luigiSiu/glowgrid/README.md

# glowgrid

An 8×8 LED panel that sits on your desk and shows whether you can be
interrupted. It follows your Mac automatically — camera on means you are in a
meeting, microphone on means you are busy — and you can override it from the
menu bar at any time.

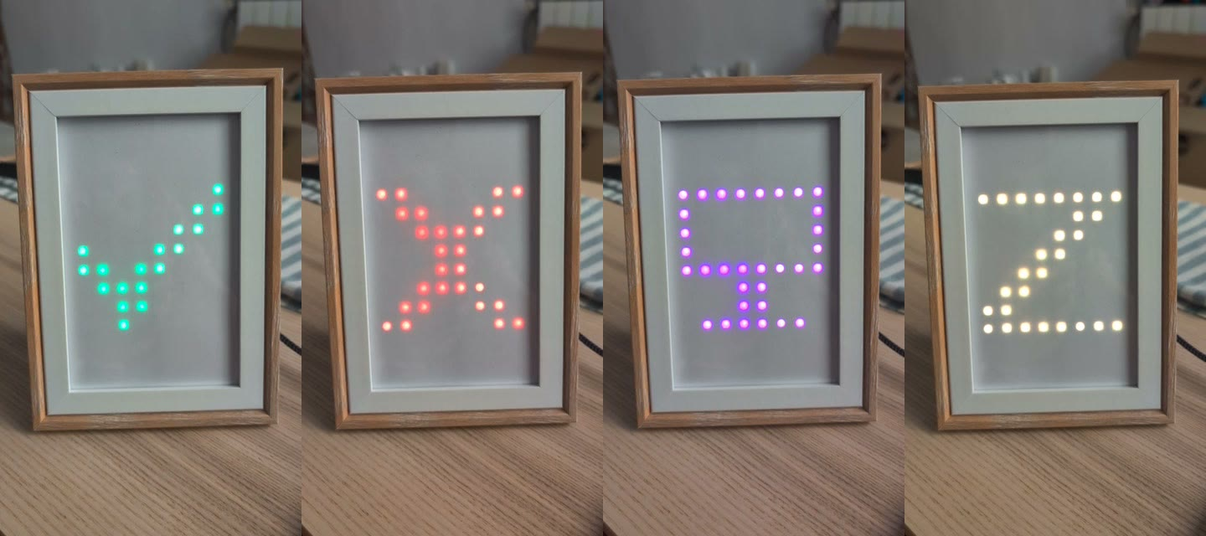
[picture p1: docs/media/states.jpg]
glowgrid in a photo frame, showing available, busy, in a meeting and away


Available, busy, in a meeting, away — behind the glass of a €6 photo frame.
▶ **[10-second clip of it cycling through the states](docs/media/frame-demo.mp4)**

About **€27 of parts** and an evening. No Xcode, no 3D printer, no breadboard,
and soldering is optional.

The Mac app is a
**[signed download](https://github.com/luigiSiu/glowgrid/releases)** — double
click and it runs. The panel you build yourself, and this README is the guide.

## What it shows

| Status | Icon | Colour |
|---|---|---|
| Available | tick | green |
| Busy | cross | red |
| In a meeting | monitor | purple |
| Away | Z | orange |
| Off | nothing | — |

Icons animate in from the centre, then breathe gently so the panel looks alive
rather than merely switched on. It can also scroll a short message.

## What you need

These are the exact parts this build used, at what they actually cost in Spain.
Nothing here is exotic or hard to substitute.

**Hardware**

- **ESP32 dev board** — [Diymore ESP32 NodeMCU, USB-C, CH340](https://www.amazon.es/dp/B0D9BTQRYT)
  — **€16 for a two-pack**, so about €8 for the one you need. Any ESP32 with
  Bluetooth works; there is nothing special about this one beyond being cheap
  and having USB-C. The pack of two is worth having anyway — a known-good spare
  is how you tell a wiring fault from a dead board.
- **WS2812B 8×8 LED matrix** — [BTF-LIGHTING WS2812B ECO, 64 pixels](https://www.amazon.es/dp/B088W62171)
  — **€13**. 80 × 80 mm, flexible, adhesive backed. Also sold as NeoPixel.
- **3 female-to-female dupont jumper leads** — a euro or two, and often already
  in the drawer.
- **A USB-C data cable.** Charge-only cables do not work and give no useful
  error whatsoever: the serial port simply never appears.
- **A photo frame**, if you want it to look finished — **under €6** from any
  cheap homeware shop. Not every frame will do; see
  [step 6](#6-put-it-in-a-photo-frame) for what to check before buying.

**Optional**

- **A USB power bank**, to run it away from the Mac —
  [Kuulaa 4500 mAh USB-C](https://www.amazon.es/dp/B0G1Y7CJ13) — **€17 for two**,
  about €8.50 each. These are tested on this build and run it without
  complaint, but read
  [Powering it from a USB battery](#powering-it-from-a-usb-battery) before buying
  any bank: capacity is not the specification that matters, and going wireless
  costs you Bluetooth range.

**Software** — a Mac running macOS 13 or later. The app itself needs nothing
installed: it is a signed, notarised download. Xcode Command Line Tools
(`xcode-select --install`) are only needed if you want to compile the app
yourself, and `arduino-cli` for the firmware — step 1 covers that.

**About €27 for one working unit**, or €36 with a battery. No resistors, no
level shifter, no breadboard, no 3D printer.

## Read this before wiring

`VIN` on the ESP32 is passed straight through from the USB 5 V rail, and USB
gives you about 500 mA. A single WS2812 LED can draw 60 mA at full white, so a
64-pixel panel at full white wants **around 3.8 A** — roughly eight times what
USB can supply.

That is fine here, because this project **never runs the panel bright**. The
firmware defaults to brightness 6 out of 255, caps it at 60, and tells FastLED
to keep total draw under 300 mA. At those levels a handful of lit pixels draws
tens of milliamps and USB power is comfortable.

Two rules follow:

- **Do not raise the brightness cap** unless you power the panel from a
  separate 5 V supply.
- If you do use an external supply, connect only `GND` and the data line to the
  ESP32, and make sure the grounds are common. **Never feed `VIN` from an
  external supply while USB is also plugged in.**

Low brightness is not just a power workaround, incidentally. These panels bloom
badly at desk distance and the icons read *better* dim than bright.

## Build it

### 1. Install the toolchain

```sh
brew install arduino-cli

arduino-cli config init
arduino-cli config add board_manager.additional_urls \
  https://espressif.github.io/arduino-esp32/package_esp32_index.json
arduino-cli core update-index
arduino-cli core install esp32:esp32
arduino-cli lib install FastLED
```

Note the board index URL. Many guides still list
`dl.espressif.com/dl/package_esp32_index.json`, which is the old one.

If you prefer the Arduino IDE, it shares `~/Library/Arduino15` with
`arduino-cli`, so configuring either configures both.

### 2. Prove the board works, before wiring anything

```sh
./flash.sh blink_test -m
```

`flash.sh` finds the serial port and pins the upload speed for you. The onboard
LED should blink once per second and the monitor should print `on` / `off`.

Do this first. If something is wrong with the board, the cable or the driver,
you want to find out now rather than while also suspecting your wiring.

**No port found?** Almost always the cable — try a known data cable before
anything else. Failing that, install the CH340 driver:

```sh
brew install --cask wch-ch34x-usb-serial-driver
```

then **restart your Mac** — not the ESP32 — and allow the kernel extension in
System Settings › Privacy & Security. This is a driver install, so it is the
Mac that needs the reboot.

**Upload hangs at `Connecting........`?** The board has two small buttons. Hold
**BOOT** as the upload starts, and release it once the dots give way to writing.
Some clones will not put themselves into the bootloader on their own.

If holding BOOT alone is not enough, do it by hand: **hold BOOT, tap EN, release
BOOT**, then start the upload. The board is now parked in the bootloader waiting
for it.

Which button is which, on the board pictured in step 3: **EN** is at the top,
next to the `VIN` end of the header. **BOOT** is at the bottom, beside the USB-C
socket. `EN` is *enable* — it simply resets the ESP32, and on its own it will not
get you into the bootloader. Worth knowing that at an angle the `EN` silkscreen
reads convincingly as `FN`.

### 3. Wire the panel

Unplug USB first.

| ESP32 pin | Panel pad |
|---|---|
| `VIN` | `5V` |
| `GND` | `GND` |
| `D13` | `DIN` |

Three wires. That is the entire circuit. `D13` on the silkscreen is `GPIO13`,
which is what the firmware drives.

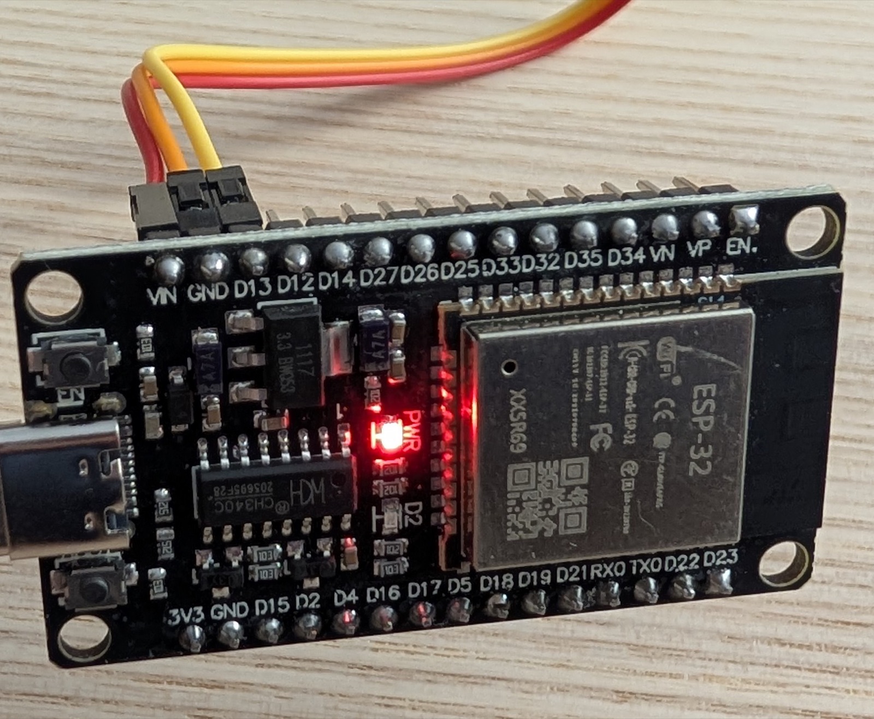
[picture p2: docs/media/esp32-wiring.jpg]
three jumper leads in VIN, GND and D13 on the ESP32


Ignore the colours of your jumper leads — the ones above are red, orange and
yellow and mean nothing at all. What matters is which pin each lands on, and
the silkscreen is legible in that photo: `VIN`, `GND` and `D13` are the first
three pins along that edge.

**The panel has three sets of wires and only one is the input.** Getting this
wrong is the most common way to end up with a dead-looking panel:

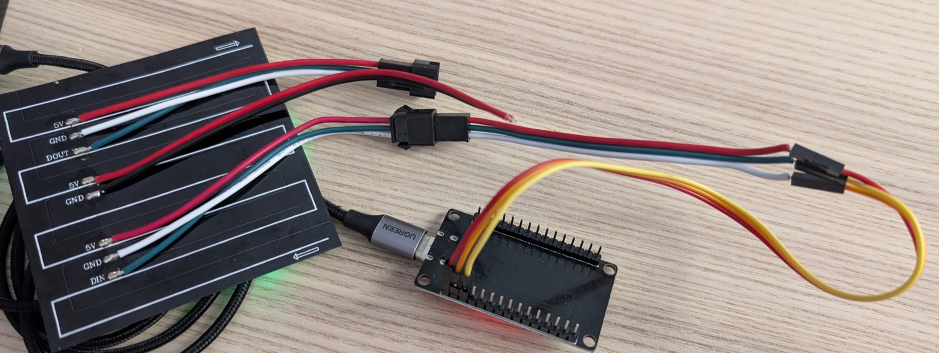
[picture p3: docs/media/panel-connectors.jpg]
the back of the panel, with all three wire sets and their labels


1. `5V`/`GND`/`DOUT`, male connector, arrow one way — the **output**, for
   chaining a second panel. Not used.
2. Two bare `5V`/`GND` wires with no connector — power injection, for an
   external supply. Not used here.
3. `5V`/`GND`/`DIN`, female connector, arrow the other way — the **input. This
   is the one.**

Each set is labelled on the PCB, as you can see above. The rule: data goes *in*
at `DIN`; `DOUT` is an exit. The arrows point opposite ways because the LED
chain snakes back and forth row by row.

Colours on the panel's own pigtail were verified by tracing on this build:
red = 5 V, white = GND, green = DIN. Pigtail colours are not guaranteed across
batches, so check yours against the printed labels rather than trusting colour.

When you hold two mated connectors face to face, the colour order *looks*
reversed. That is a mirror effect, not a fault.

**On soldering.** You do not have to solder anything. The pigtail ends push
straight into female dupont leads, and this project ran that way for weeks. It
is a friction fit though, so twist each bare end tightly, push it fully home,
and keep the three joints apart. Intermittent data shows up as flicker or wrong
colours; intermittent power shows up as the panel resetting — suspect these
joints first.

If you do own an iron, soldering the pigtail to a set of jumper leads (which is
what the photo above shows) takes ten minutes and removes that entire category
of fault. It is the one upgrade that makes the build feel less fragile.

### 4. Flash the firmware

```sh
./flash.sh
```

That builds and uploads `status_ble`, the sketch you actually want. The panel
should light up dim, and the board starts advertising over Bluetooth as
`glowgrid`.

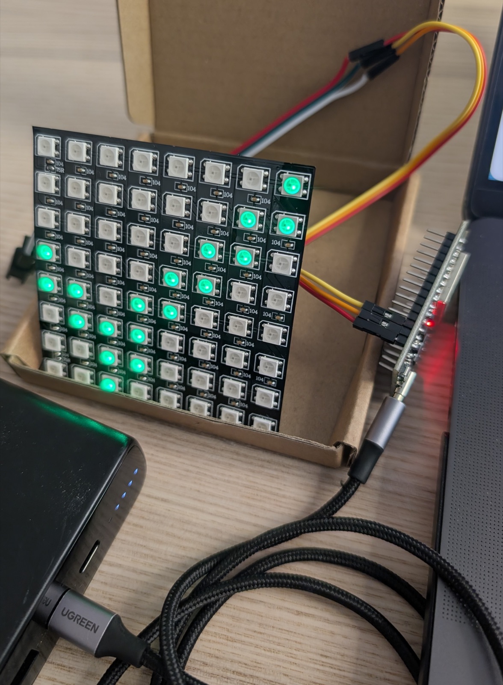
[picture p4: docs/media/bench-test.jpg]
the bare panel lit with a green tick, running from a USB power bank


First light. Two things in that photo are worth noticing, because each is the
point of a later step:

- It is running from a **USB power bank**, not the Mac. The panel does not care
  where its 5 V comes from — see
  [Powering it from a USB battery](#powering-it-from-a-usb-battery).
- Bare, the LEDs read as **64 separate dots** with visible halos. The shape is
  legible, but it looks like a circuit board, because it is one. Step 6 is what
  fixes that.

### 5. Install the Mac app

Download `Glowgrid-<version>.zip` from
[Releases](https://github.com/luigiSiu/glowgrid/releases), unzip it and drag the
app to `/Applications`. It is signed and notarised, so it opens with a double
click like anything else you download.

Or build it from source, which takes one command:

```sh
cd mac-app
./build.sh -i
```

This compiles the app, installs it to `/Applications` and launches it. A
Bluetooth icon appears in your menu bar and macOS asks for Bluetooth
permission once.

It starts in **Automatic** mode, so once it finds the panel it is already
following your camera and microphone. There is nothing to switch on.

Install to `/Applications` before turning on "Launch at login" — macOS records
the app's *location* in the login item, so one registered from a build
directory breaks the moment you rebuild.

▶ **[Watch the app driving the panel](docs/media/app-demo.mp4)** — 80 seconds of
picking statuses by hand, then leaving it on Automatic and letting the
microphone switch it to *busy* on its own.

### 6. Put it in a photo frame

Optional, and the best improvement per euro in the entire project. A bare panel
on a desk looks like a project. The same panel behind glass with a diffuser
looks like something you bought.

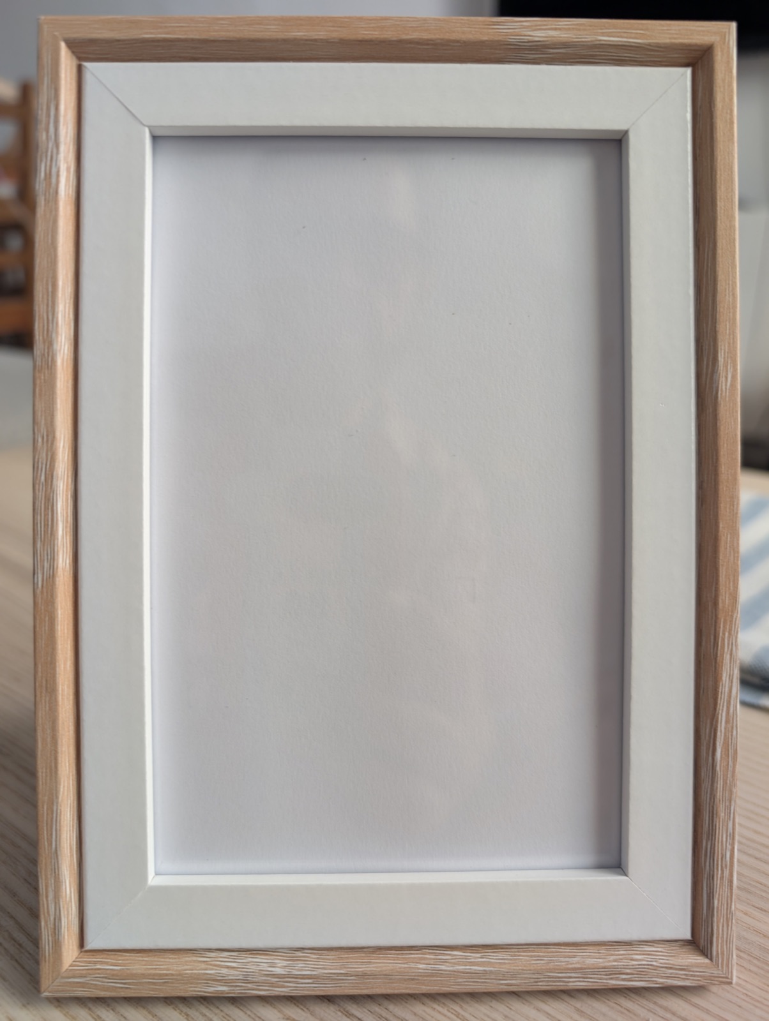
[picture p5: docs/media/frame-empty.jpg]
an empty wooden photo frame with a white mat


**Under €6 from a cheap homeware shop.** Not every frame works, so check for:

- **A mat** — the white card border. This is the part that does the visual work:
  it hides the panel's edges, its dark PCB and the wiring, so all you see is an
  icon floating in white. A frame without a mat shows the whole board.
- **Depth.** There must be room behind the glass for the panel plus a few
  millimetres of air. Deep-rebate or "box" frames are ideal.
- **A fold-out stand**, so you do not have to make one.
- **An MDF backer** you do not mind drilling.

Then three holes in the backer — one for the wires to reach the back, and two
for screws to hold the ESP32:

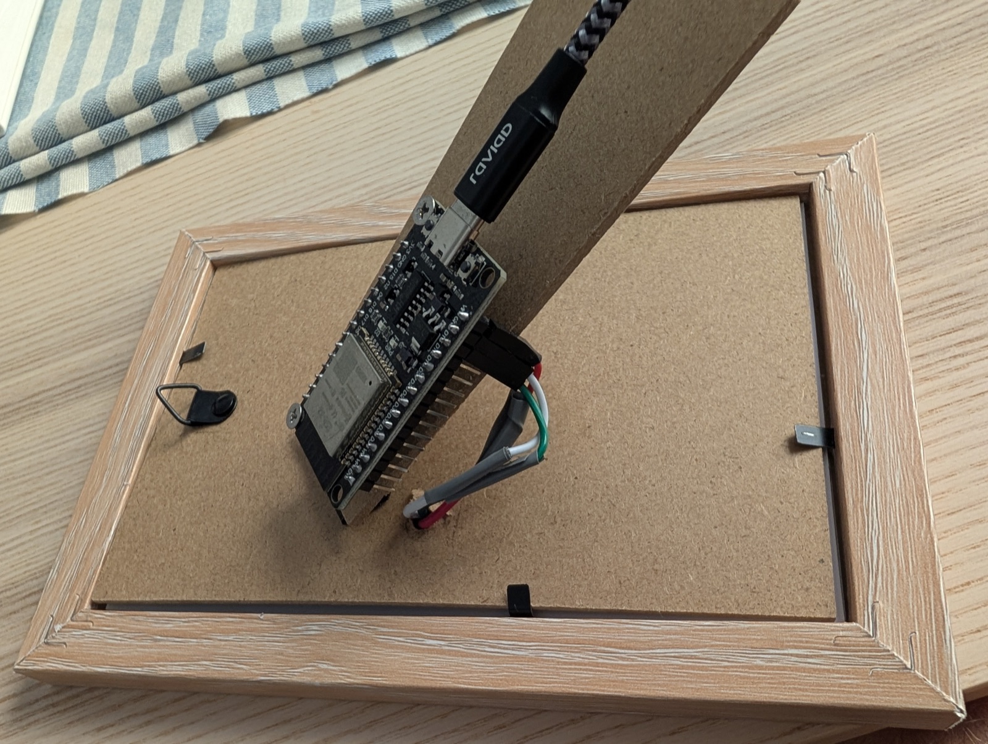
[picture p6: docs/media/frame-assembly.jpg]
the ESP32 screwed to the frame backer, wires passing through


And the part that actually matters: **two sheets of plain white paper between
the panel and the glass.** That is the diffuser. Free, and it works — each LED
spreads into a soft round dot instead of a hard bright point, and when the panel
is off the frame just looks like an empty frame.

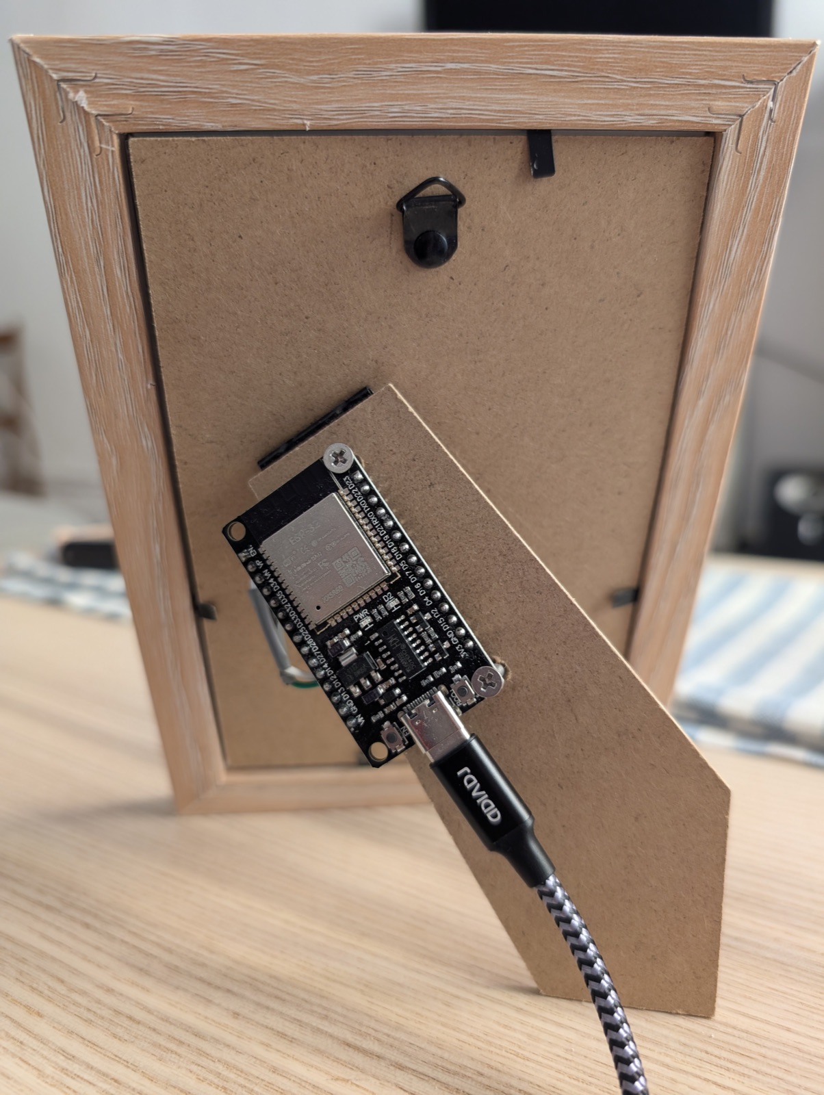
[picture p7: docs/media/frame-back.jpg]
the finished back, kickstand out, USB-C plugged in


The USB-C socket ends up pointing down and slightly outward, so the cable leaves
tidily behind the stand.

Two things learned doing this:

- **Diffusion costs brightness.** It always does. You will probably want a step
  or two more after fitting the paper — `b+` in the app, or
  `glowgrid --brighter`. There is plenty of headroom below the cap of 60.
- **The air gap matters more than the material.** The paper sits against the
  glass with the panel a few millimetres behind it, and that small gap is what
  turns points of light into round dots. Press any diffuser flat against the
  LEDs instead and you get hotspots with muddy halos.

## Using it

Click the menu bar icon. It shows:

- **Connection state** — a green dot when the panel is actually reachable.
- **The five statuses.** Picking one switches to manual mode; it stays until
  you change it.
- **Automatic** — camera in use → *meeting*, microphone in use → *busy*,
  neither → *available*. **On by default**, because a status light you have to
  remember to update is a worse version of just telling people you are busy.
- **…and my calendar** — also show *meeting* while a calendar event is running.
  Off until you enable it, and it asks permission the first time.
- **Brightness** — `−` / `+`. The number shown is read back from the panel
  itself, so it is right even if something else changed it.
- **A message field** — scroll up to about 160 characters across the panel.
  Shown in capitals; the font has no lowercase. *Clear* returns to the status.
- **Panel** — which glowgrid to talk to, remembered between launches. Only
  matters if you build more than one.
- **Launch at login.**

Manual and automatic are deliberately explicit modes rather than "manual wins
for 20 minutes". A panel that reverts on its own with no visible cause feels
haunted; one that stays where you put it does not.

**Your choice of mode is remembered.** A fresh install starts in Automatic, but
if you switch to Manual it will still be in Manual tomorrow — quietly flipping
back to Automatic overnight would be the same invisible state change the
explicit modes exist to avoid.

One consequence worth knowing: in Automatic the app owns the status, so when it
connects it will overwrite whatever the panel was showing, including something
you set from the CLI. In Manual it pushes nothing until you actually pick a
status, so a CLI-set panel is left alone.

### Why the calendar as well as the camera?

Camera and microphone answer "are you talking to someone right now", which
misses the worst moment: the first minutes of a meeting, when you are walking
to a room or waiting with your camera off, and the panel is cheerfully showing
*Available* exactly when someone is most likely to interrupt.

Events are ignored if they are all-day, marked Free, cancelled, or you declined
them. Camera still outranks the calendar, so an unscheduled call shows as a
meeting too.

Nothing about your calendar leaves your Mac.

## Command-line tools (optional)

The app covers everything. These exist because they came first, and they are
still handy for scripting.

```sh
mac-cli/glowgrid.py busy
mac-cli/glowgrid.py --text "BACK AT 3"
mac-cli/glowgrid.py --brightness 10
mac-cli/glowgrid.py --brighter        # or --dimmer
mac-cli/glowgrid.py --clear
mac-cli/glowgrid.py --raw "b:12"      # send a command verbatim
mac-cli/glowgrid.py --scan            # list nearby BLE devices
mac-cli/glowgrid.py --forget          # drop the cached device address
```

The script carries PEP 723 inline dependency metadata, so `uv` builds its
environment on the fly — nothing to install and no venv to activate. The device
address is cached in `~/.cache/glowgrid/address`, which cuts a status change
from about 8 s to 1.5 s.

To call it from anywhere, symlink rather than copy, so edits take effect
immediately:

```sh
ln -s "$PWD/mac-cli/glowgrid.py" ~/.local/bin/glowgrid
```

It can run while the app is connected: the firmware keeps advertising after a
client connects, so several clients can talk to the panel at once.

**`glowgrid-watch.py` is superseded by the app.** It polls the camera and
microphone and sets the status, which is exactly what Automatic does — but
without a persistent connection, so every change costs a full connect cycle. It
is kept for headless use and as the reference implementation of the detection
logic. If you are running the app, do not run the watcher as well; they will
fight over the panel.

Both tools need Bluetooth permission for your terminal app (System Settings ›
Privacy & Security › Bluetooth). Without it the process dies with `SIGABRT` and
no useful message.

## Bluetooth protocol

```
device name  glowgrid
service      6E400001-B5A3-F393-E0A9-E50E24DCCA9E
RX           6E400002-B5A3-F393-E0A9-E50E24DCCA9E   (write + read)
```

Write plain ASCII:

| Command | Effect |
|---|---|
| `available` `busy` `meeting` `away` `off` | set the status |
| `0` `1` `2` `3` `4` | the same, by index |
| `b:<1-60>` | set brightness |
| `b+` / `b-` | step brightness by 2 |
| `t:<message>` | scroll a message (max 160 chars) |
| `clear` | back to showing the status |

Reading the same characteristic returns the current state:

```
status=busy brightness=10 mode=status
```

Unrecognised commands are ignored rather than rejected, so a typo does nothing
and reports nothing.

Those long hex strings are the **Nordic UART Service** UUIDs, and they are
borrowed on purpose.

Every BLE service and characteristic is identified by a UUID, and you are free
to invent your own — but an invented UUID means nothing to anyone else, so no
existing app knows what to do with it. Nordic's serial-port service is a de
facto standard that generic BLE tools already recognise. By reusing its UUIDs,
phone apps like **nRF Connect** or **LightBlue** show glowgrid as a device with
a text box you can type `busy` straight into — with no client code written at
all.

That is exactly how this protocol was tested before a line of Mac code existed,
and it is still the fastest way to check whether a problem is in the firmware or
in the app. Nothing here is really a UART; the name is inherited along with the
UUIDs.

Brightness is saved to the ESP32's non-volatile storage and restored on boot,
and only written when it actually changes, since flash has finite write cycles.

## Troubleshooting

**The panel does nothing after flashing.** Check `DIN`, not `DOUT` — see the
three-wire-sets section above. Then check the ground connection.

**Wrong colours, or flicker.** Usually a loose data joint. Note also that the
ESP32 outputs 3.3 V logic while WS2812 wants around 4 V on `DIN`; it works on
short wires, but a level shifter fixes it if colours are unstable.

**The app says "Searching for a panel…" forever.** Is the board powered? Is
another client holding it? Try `mac-cli/glowgrid.py --scan`.

**Upload fails with "Unable to verify flash chip connection".** Upload speed.
`flash.sh` already pins 115200; if you are calling `arduino-cli` by hand, add
`:UploadSpeed=115200` to the FQBN.

**"Port is busy or doesn't exist".** macOS names the port after the physical
USB socket, so it changes when you replug into a different one. `flash.sh`
detects it; `arduino-cli board list` shows it.

**The serial monitor freezes at `configsip:`.** This is *not* a crash. With BLE
running, monitor output can stop at the bootloader line while the sketch runs
perfectly. Do not use the monitor as a liveness check — use a BLE scan or read
the state characteristic. This cost real time here, twice.

**Bluetooth permission was granted but the app still cannot connect.** Quit and
relaunch; macOS occasionally needs it after a permission change.

**It was reliable across the room on USB, and now drops out on battery.** Not a
fault — a power bank pressed against the board costs you radio range. See
[Powering it from a USB battery](#powering-it-from-a-usb-battery).

## How it works

### Panel layout

Determined empirically with `xy_calibrate`, not assumed:

- chain index 0 is the **bottom-left** pixel
- the chain runs in **horizontal rows of 8**
- the bottom row runs left to right and each row above reverses
  (**serpentine**)

`XY(x, y)` in the firmware hides all of that behind ordinary screen
coordinates — origin top-left, x right, y down — so everything above it can
pretend the panel is a normal grid.

Colour order is **GRB**, not RGB. If your reds come out green, that is why.

### Icons

The glyphs went through four iterations: thin strokes (too faint), a coloured
disc with a white symbol (the fill drowned the symbol), a white disc with a
coloured symbol (same problem, and every state looked like a white blob), and
finally a big symbol on black with no fill.

The lesson: at 8×8 the *shape* has to be the icon. A background fill spends
most of your 64 pixels on something carrying no information. Strokes are two
pixels thick wherever possible, because single-pixel lines vanish at a glance.

### Detecting camera and microphone

Two supported "is this device running for anybody" properties:

- `kAudioDevicePropertyDeviceIsRunningSomewhere` (CoreAudio) for the microphone
- `kCMIODevicePropertyDeviceIsRunningSomewhere` (CoreMediaIO) for the camera

Neither needs camera or microphone permission, because no media is ever
accessed — only device state. So the app asks for Bluetooth and, optionally,
calendar, and nothing else.

Two tempting alternatives were rejected: scraping `log stream` depends on
private subsystem names that change between macOS releases, and matching
process names only proves an app is open, not that it is capturing.

Output-only audio devices are skipped explicitly. Without that, playing music
registers as microphone activity and shows you as busy.

## Powering it from a USB battery

Cutting it loose from the Mac is what makes it feel like an appliance rather
than a peripheral, and it needs no changes at all: the bank simply replaces the
Mac as the USB power source. The bench photo in step 4 is running that way.

One specification decides whether a given bank is suitable, and it is not
capacity:

- **Current is not the problem.** The ESP32 with BLE averages 80–150 mA, and
  the panel at these brightness levels adds only tens of milliamps.
- **Auto-shutoff is the problem.** Many power banks switch themselves off when
  draw falls below roughly 50–100 mA, assuming nothing is plugged in. This load
  sits right around that threshold, so some banks will cut out after a few
  minutes. Look for one advertising a low-current, trickle or "small device"
  mode — this is the single thing that decides whether the idea works.
- **Runtime is not the problem either.** Even a small 4500 mAh bank is roughly
  3,000 mAh usable after conversion losses — a full day at ~150 mA. A
  10,000 mAh bank is several days.
- **Trade-off:** on battery there is no serial console, and reflashing means
  going back to the Mac.

This build used [Kuulaa 4500 mAh USB-C banks](https://www.amazon.es/dp/B0G1Y7CJ13),
€17 for two, which are small enough to sit behind the frame rather than beside
it. **They are now tested and they work smoothly** — no auto-shutoff, no
cutting out, the panel simply stays lit. If yours does die after a few minutes,
that is the auto-shutoff above and not a fault in your wiring. Raising the
brightness is the crude fix, since it pushes draw above the cutoff, and it looks
better anyway.

### The battery costs you Bluetooth range

This was the surprise, and it is the one real downside of going wireless.

On USB power from the Mac, the panel held its connection from **more than two
metres away with a wall in between**. Running from the bank tucked behind the
frame, it wants to be **within about a metre, in sight of the Mac**, or the app
starts losing it.

The likely reason is a nice lesson in why radio is not like wiring. The ESP32's
2.4 GHz antenna is not a component you can point at — it is a copper trace at
one end of the board, and it is tuned assuming empty space around it. Two things
change when a battery is strapped to it:

- **Detuning.** A lithium pack is a large conductive slab in a metal-ish shell.
  Put it in the antenna's near field and it becomes part of the antenna,
  shifting its resonance away from 2.4 GHz and absorbing energy that should be
  radiating.
- **Noise.** The switching regulator that steps the cell up to 5 V is a small
  broadband transmitter. Its harmonics reach into the same band Bluetooth uses,
  so the noise floor at the receiver goes up while the signal goes down.

Worth trying before accepting the shorter range:

- **Move the bank away from the antenna end** of the board — the far corner of
  the frame is better than directly behind it.
- **Leave a couple of centimetres of air** between pack and board. Even a small
  gap is a real improvement, because near-field effects fall off fast.
- **Do not put the pack between the panel and the Mac.** Give the antenna a
  clear line to the computer.
- **Longer USB cable, bank further away** — the cheapest fix, at the cost of a
  cable to hide.

Honest caveat: this was observed by moving the thing around a room and watching
the app's connection dot, not measured with a spectrum analyser. The distances
are what this build does in this flat, with these walls. Treat them as the shape
of the problem rather than as specifications.

If you want the range back, keep it on USB. The frame ends up near the desk
anyway, which is where you want to see it.

## Sharing it with someone else

The build attached to each [release](https://github.com/luigiSiu/glowgrid/releases)
is signed with a Developer ID certificate and notarised by Apple, so it opens
with a double click on any Mac — no right-click-Open, no scary dialog. It is a
universal binary, so Apple Silicon and Intel both work. First launch still asks
for Bluetooth permission, which is the app doing what it says on the tin.

What `build.sh` produces is **ad-hoc signed** and deliberately different. It is
fine on the machine that built it and Gatekeeper will refuse it anywhere else,
which is exactly why release builds go through the script below instead.

### Cutting a release

```sh
cd mac-app
./release.sh                  # build, sign, notarise, staple, zip
./release.sh --skip-notarize  # signing only, for when you are changing the script
```

The output lands in `mac-app/build/dist/Glowgrid-<version>.zip`, ready to attach
to a GitHub release.

Gatekeeper wants three separate things, and missing any one of them produces the
same unhelpful "Apple could not verify this app is free of malware":

1. **A Developer ID Application certificate.** Not *Apple Development* (your own
   machines only) and not *Apple Distribution* (the Mac App Store). Distinct
   certificate type, same portal. Create it in Xcode › Settings › Accounts ›
   your team › Manage Certificates › + › Developer ID Application.
2. **The hardened runtime and a secure timestamp.** The notary service rejects
   anything without both. The hardened runtime also means the resources the app
   uses have to be declared in `Glowgrid.entitlements` — Bluetooth and, if you
   turn it on, calendar. Camera and microphone are *not* declared, because the
   app only reads whether those devices are in use and never opens a stream.
3. **A notarisation ticket, stapled.** Uploading gets you a verdict; stapling
   writes it into the bundle. Skip the stapling and macOS has to phone Apple on
   first launch, so anyone offline sees the warning on a perfectly good app.

One-time setup for notarisation: create an app-specific password at
[appleid.apple.com](https://appleid.apple.com) (Sign-In and Security ›
App-Specific Passwords), then store it in your keychain once:

```sh
xcrun notarytool store-credentials glowgrid-notary \
  --apple-id you@example.com \
  --team-id YOURTEAMID
```

After that the password lives in the keychain and never appears in a script, a
shell history or a CI log.

Two things worth knowing. The secure timestamp is why the app keeps launching
after the certificate eventually expires — the signature is provably from when
it was still valid. And changing signing identity resets the app's permission
grants, so the first launch of a newly signed build re-prompts for Bluetooth
even on the machine that built it. Expected, not a bug.

### Version numbers, and where they live

One `MAJOR.MINOR.PATCH` number for the whole project, kept in three places that
have to agree:

- **`mac-app/Resources/Info.plist`** — `CFBundleShortVersionString`. What the
  app reports to macOS, what Finder shows in Get Info, and what names the zip.
- **`pyproject.toml`** — the repository's own version, which is what Python
  tooling reads.
- **The git tag**, `v0.1.0`, which is what the GitHub release hangs off.

Three copies is one more than anybody wants, and there is no clever fix worth
having here: each is read by a different toolchain that cannot see the other
two. A generator would be more machinery than the problem deserves, so instead
it is a checklist — and [CHANGELOG.md](CHANGELOG.md) is where the actual story
of what changed lives.

`CFBundleVersion` next to it is a different thing: a build counter, not a
version. It only has to increase, and only really matters to the App Store.

Cutting a release, in order:

```sh
# 1. bump Info.plist and pyproject.toml, write the CHANGELOG entry
# 2. build the signed, notarised artefact
cd mac-app && ./release.sh

# 3. commit, tag, push
git tag v0.1.0 && git push origin v0.1.0

# 4. publish, attaching the zip release.sh produced
gh release create v0.1.0 mac-app/build/dist/Glowgrid-0.1.0.zip
```

Build the artefact *before* tagging, not after. If notarisation fails you want
to find out while the tag does not exist yet, because a pushed tag that points
at a release you could not build is a small mess to undo.

## Repository layout

```
status_ble/         the firmware that runs on the board  <-- the real one
  font5x7.h         hand-written 5x7 font for scrolling text

mac-app/            the menu bar app (Swift, no Xcode project)
  Sources/          BLE client, sensors, status logic, UI
  icon/             the app icon, drawn by code
  build.sh          compile / install            <-- the dev loop
  release.sh        sign, notarise, staple, zip  <-- cutting a release
  Glowgrid.entitlements   what the hardened runtime is allowed to touch

mac-cli/            optional command line tools
  glowgrid.py       set status, brightness or text over BLE
  glowgrid-watch.py camera/mic watcher (superseded by the app)
  media-sensor/     the detector, as a standalone Swift binary

flash.sh            build and upload a sketch, finding the port

CHANGELOG.md        what changed in each release, and why
pyproject.toml      the repository version, for the Python side

docs/media/         the photos and clips used by this guide

blink_test/         step 0  onboard LED only, no wiring
matrix_test/        step 1  first light on the panel
xy_calibrate/       step 2a discover the physical layout
xy_test/            step 2b validate the XY() mapper
status_display/     step 3  the five states on a timer, no Bluetooth
```

The numbered sketches are **frozen snapshots of each step**, not living code.
They are kept so any layer can be reflashed in isolation when something breaks;
only `status_ble` is maintained.

There is no `.xcodeproj` on purpose. An Xcode project is a large generated blob
that cannot be reviewed in a diff, and it buys nothing for an app this size:
`build.sh` is 100 lines of `swiftc`.

## Notes from the build

Things that cost time here, recorded so they cost you less:

- **The CH340 clone cannot handle the default 921600 upload baud.** It connects,
  reads the chip ID, then dies with "Unable to verify flash chip connection".
  Always 115200.
- **`arduino-cli upload` does not compile first.** Use
  `arduino-cli compile --upload`, or just use `flash.sh`.
- **Arduino injects function prototypes** above the first function definition,
  so any `enum` used in a function signature must be declared before it.
- **Do not name an enum `Status` in a sketch that uses BLE.**
  `BLECharacteristicCallbacks` has a nested `Status` that shadows yours inside
  derived classes, producing a genuinely baffling error. The firmware's is
  called `Presence`.
- **A BLE peripheral stops advertising once a client connects.** This looked
  exactly like a dead board: with the app connected, the panel vanished from
  every scan and the CLI reported "could not find glowgrid". Calling
  `startAdvertising()` in `onConnect` fixes it, and allows several clients at
  once as a bonus.
- **The serial monitor is not a liveness check with BLE running.** See
  troubleshooting. This one misled the build twice.
- **`status_ble` sits at about 94% of the default app partition.** There is
  room, but not much. If you switch partition scheme, erase flash first.
- **A `TextField` in a `MenuBarExtra` menu simply does not render.** The `.menu`
  style is a real `NSMenu` and only holds menu items, which is why the app uses
  the `.window` style. And because a menu-bar-only app is an *accessory* app
  whose windows cannot become key, it has to activate itself when the panel
  opens or the text field ignores every keystroke.
- **A power bank strapped to the board costs you Bluetooth range**, dropping a
  comfortable two-metres-through-a-wall down to about one metre in sight. The
  battery detunes the antenna trace and its regulator raises the noise floor.
  Nothing about the code changed; the radio's surroundings did.
- **Three certificate types are called "distribution" in spirit and only one
  works.** *Apple Development* covers your own machines, *Apple Distribution*
  is the Mac App Store, and *Developer ID Application* — a separate type in the
  same portal — is the one that lets a download open on a stranger's Mac.
  Signing with the wrong one fails identically to not signing at all.

## Licence

MIT — see [LICENSE](LICENSE).
