luigiSiu/glowgrid/docs/media/README.md

# Media

Photos and clips used by the [build guide](../../README.md). This file replaces
an earlier `docs/photos/README.md`, which was a wish list of shots to take —
obsolete now that the shots exist.

| File | What it shows | Used in |
|---|---|---|
| `states.jpg` | The four statuses in the frame, side by side | Top of the README |
| `frame-demo.mp4` | 10 s, the finished panel cycling through statuses | Top of the README |
| `finished-available.jpg` | Single frame: the green tick behind glass | spare |
| `esp32-wiring.jpg` | Jumper leads in `VIN`, `GND`, `D13`, silkscreen legible | Step 3 |
| `panel-connectors.jpg` | Panel back, all three wire sets and their labels | Step 3 |
| `bench-test.jpg` | Bare panel lit, running from a power bank | Step 4 |
| `app-demo.mp4` | 80 s, the menu bar app and automatic detection | Step 5 |
| `frame-empty.jpg` | The empty photo frame before conversion | Step 6 |
| `frame-assembly.jpg` | ESP32 screwed to the backer, wires fed through | Step 6 |
| `frame-back.jpg` | Finished back, kickstand out, USB-C connected | Step 6 |

The still frames in `states.jpg`, `finished-available.jpg` and the diffused
frame shots are pulled from `frame-demo.mp4`, so they are only 360 px wide.
Fine at the size the README displays them; replace them with proper stills if
they ever need to be larger.

## If you shoot more

Photograph the panel **dim**. LEDs at anything above brightness 10 blow out to
white blobs on camera and the shape of the icon disappears entirely, even though
it looks fine to the eye. Some ambient light helps too — a pitch-dark room gives
the camera nothing to expose for except the LEDs.
