luigiSiu/glowgrid/docs/media/finished-available.jpg

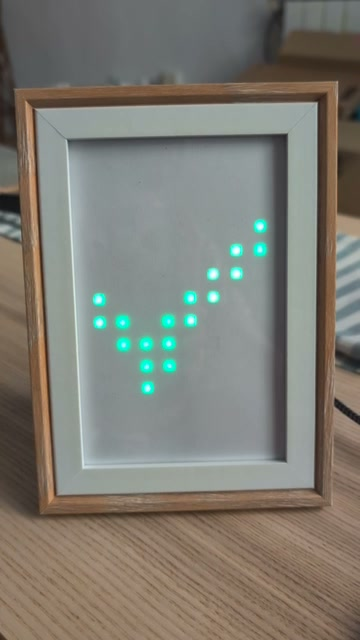
docs/media/finished-available.jpg
