luigiSiu/glowgrid/(commit log)

2026-08-08 Redesign icons as full-bleed glyphs with continuous animation
    Icons went through three iterations before landing here. Thin strokes on
    black were too faint; a coloured disc with a white symbol was bright but
    the fill drowned the symbol; inverting it made both states read as a white
    blob from any distance. Final form is a single large coloured glyph on
    black, 2px strokes, touching all four edges.
    - Replace tick/bar/disc artwork with full-bleed TICK, CROSS, MONITOR and Z
    - Animate a radial reveal on status change, blooming out from the centre
    with each pixel travelling white to its final colour
    - Keep the icon alive once settled: a slow breathe plus a highlight that
    sweeps diagonally ever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
    [status_ble.ino]
2026-08-08 Add native macOS menu bar app (#2)
    Replaces the terminal workflow with a menu bar app that owns everything:
    Bluetooth, camera/mic detection and the UI, in one binary. The Python CLI
    and watcher are untouched and still work.
    Built with swiftc into a .app bundle by build.sh, with no Xcode project.
    An .xcodeproj is a large generated blob that is painful to review and buys
    nothing at this size; everything here stays as readable source.
    The bundle is not optional. macOS only reads Info.plist from a bundle, and
    we need LSUIElement (menu bar only, no Dock icon) and
    NSBluetoothAlwaysUsageDescription. Without the latter, CoreBluetooth access
    is killed with SIGABRT and no usable error - the exact fa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
2026-08-08 Rewrite the README as a build guide, add a licence and photo slots (#6)
    The README was an honest build log: written in the order things were
    discovered, which is why the gotchas are good and why it was useless to
    anyone trying to reproduce the project. It also drifted out of date - it
    documented the blue connection dot removed two PRs ago, never mentioned the
    menu bar app at all, described only a third of the BLE protocol, referenced a
    glowgrid.ino that does not exist, and told you to run `arduino-cli upload`
    some 200 lines before explaining that this does not compile.
    It is now ordered the way somebody builds the thing: what it does, what to
    buy, the power warning BEFORE any wiring, five n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
2026-08-09 Fix reconnection: come back on our own and restore the status (#7)
    Power cycling the panel left it dark until you picked a status by hand, and
    the app happily accepted changes while nothing was listening. Three separate
    faults.
    The app never reconnected on its own. On disconnect it only restarted a scan,
    and the scan handler skips any peripheral it already holds a reference to -
    which is never cleared. So unless the user had explicitly picked a panel from
    the picker, the app sat at "Searching" forever after the first disconnect. It
    now re-issues the connect request, which CoreBluetooth keeps pending and
    completes by itself when the board comes back.
    Nothing told the panel what to show afte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
2026-08-18 Illustrate the build guide: real photos, real parts, real prices (#8)
    * Illustrate the build guide with real photos, parts and prices
    The guide described a build nobody could see. It now has the photos, and the
    parts list has actual products and actual prices instead of hand-waving.
    Bill of materials. Replaced "the ubiquitous ~6 EUR clone" and "roughly 8 EUR"
    with the things actually bought, linked, at what they actually cost: the ESP32
    NodeMCU (USB-C, CH340) at 16 EUR, the BTF-LIGHTING panel at 13 EUR, and the
    Kuulaa power banks at 17 EUR. Two of those are multi-packs, which the guide now
    says explicitly with the per-unit price, because a reader comparing totals
    would otherwise conclude t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
2026-08-25 Sign and notarise the Mac app so it opens on other people's Macs (#9)
    Until now the only honest advice for sharing the app was "build it
    yourself": build.sh signs ad-hoc, which is fine on the machine that
    built it and refused everywhere else. With a Developer ID certificate
    available, releases can be signed properly instead.
    release.sh is separate from build.sh rather than a flag on it. Release
    signing needs the network, takes minutes instead of seconds, and burns a
    notarisation submission every run — none of which belongs in a loop you
    run fifty times a day. It reuses build.sh for the compile so there is
    one definition of how the bundle is assembled, then replaces the ad-hoc
    signature.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
2026-08-25 Bring the docs up to date for the first release (#10)
    The signing work landed but the documentation still described the world
    before it, and the battery question had been left open since the power
    bank arrived. Both are now answered, plus the housekeeping a first
    release needs.
    The app is a download now, and the docs lead with that. The intro, the
    requirements and step 5 all assumed you would compile it yourself, so
    Xcode Command Line Tools were listed as a hard requirement when they are
    only needed if you build from source.
    The power banks are tested and they work: no auto-shutoff, no cutting
    out. But going wireless turned out to cost Bluetooth range - reliable at
    over two metres through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
2026-09-08 Ignore uv.lock and .venv
    Running any uv command from the repo root makes uv treat this as a
    Python project and write a lock file. It locks nothing - pyproject.toml
    declares no dependencies on purpose, and the tools in mac-cli/ pin theirs
    inline with PEP 723 - so committing it would imply a dependency set that
    does not exist. .venv was already ignored only by the one uv drops inside
    it, which is easy to lose.
